GormR/AgOpenGPS_ADS1115_simulator_for_rotary_encoder/AOG_ADS1115_simulator_for_rotary_encoder.png

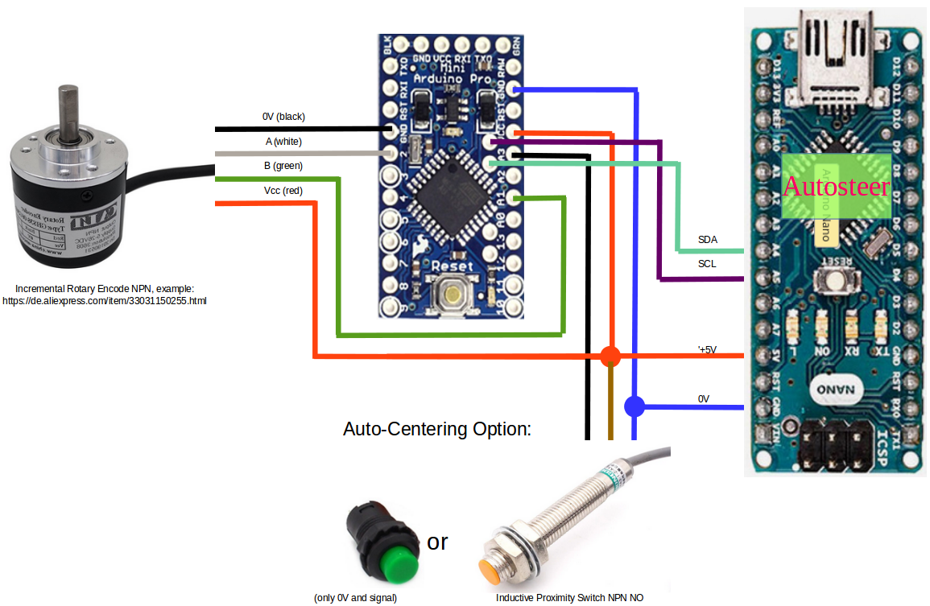
AOG_ADS1115_simulator_for_rotary_encoder.png
