GormR/AgOpenGPS_ADS1115_simulator_for_rotary_encoder/README.md

# AgOpenGPS_ADS1115_simulator_for_rotary_encoder
eliminates the need of a wheel angle sensor for AgOpenGPS when using a steering wheel motor and rotary encoder
