GormR/AgOpenGPS_ADS1115_simulator_for_rotary_encoder/20201010_183013_resized.jpg

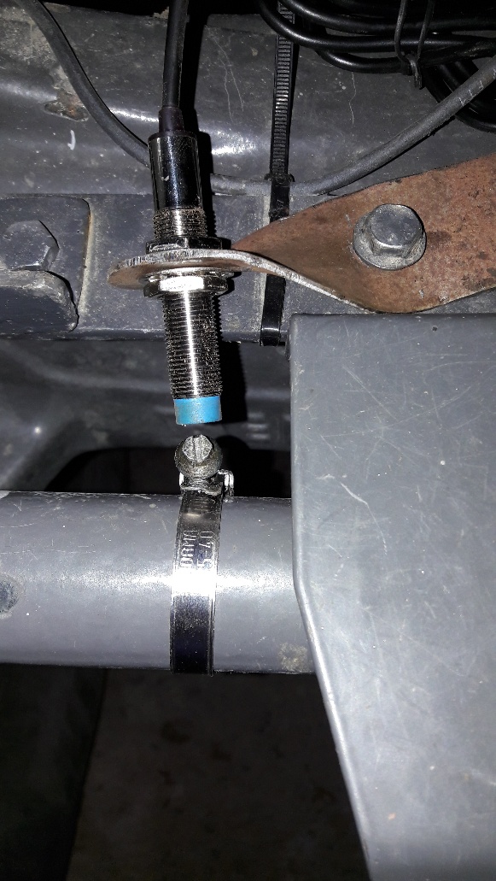
20201010_183013_resized.jpg
