GormR/AgOpenGPS_ADS1115_simulator_for_rotary_encoder/AOG_Autosteer_4.3.10_for_rotary_encoder.png

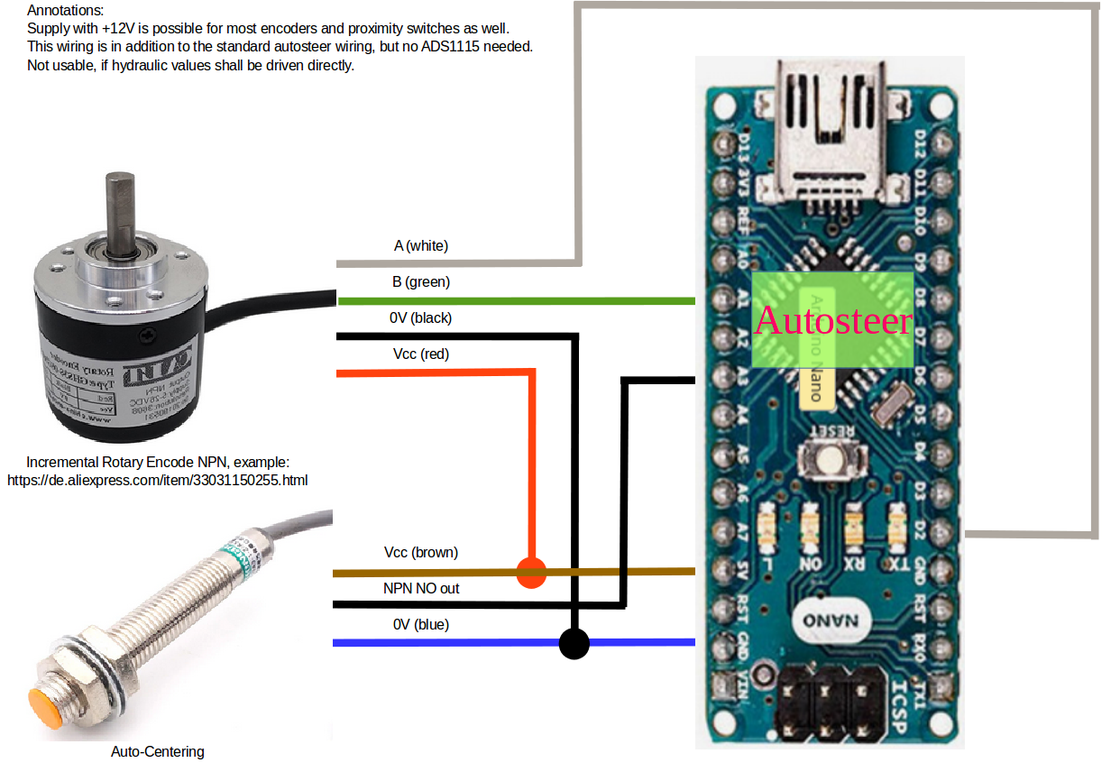
AOG_Autosteer_4.3.10_for_rotary_encoder.png
