GormR/AgOpenGPS_ADS1115_simulator_for_rotary_encoder/Gear_Rotary_Encoder.stl

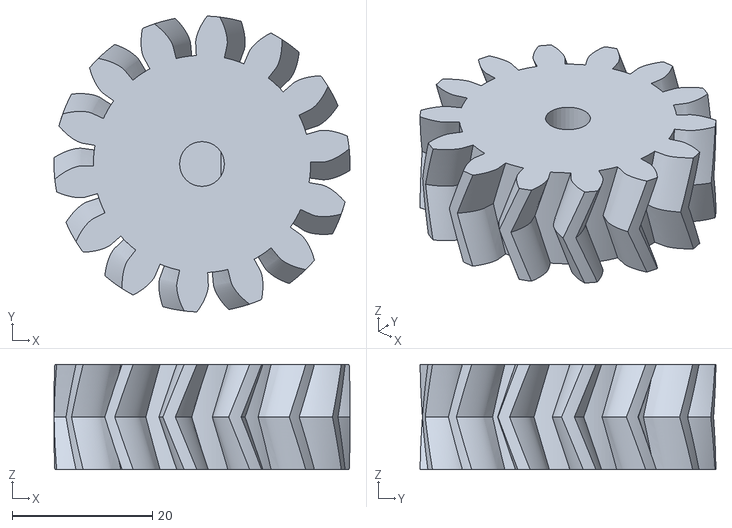
[picture p5: CAD file, 2020-10-09]
Gear_Rotary_Encoder.stl
42.2 x 42.2 x 15.0
