GormR/AgOpenGPS_ADS1115_simulator_for_rotary_encoder/Einrichtung_Drehgeber_für_Lenkung.pdf

Inbetriebnahme
Einrichtung der Lenkwinkelsensorik mit Inkremental-Drehgeber
1. Messung des max. Lenkwinkels als Mittelwert aus dem Winkel des inneren und äußeren Rads
2. Arduino einschalten und einmal kurz nach ganz links und ganz rechts lenken
3. Positive Winkel sollten beim Lenken nach rechts angezeigt werden; sonst „Invert WAS“ aktivieren
4. Werte abspeichern durch Drücken von „Send To Module“ („Ackermann“ := 100%)
5. „Counts per Degree so einstellen, dass der Winkel „Act:“ mit dem in 1. gemessenen übereinstimmt.
5. „Max Steer Angle In Degree“ sollte nun etwas niedriger als der in 1. gemessene Winkel eingestellt werden.
7. Optional, je nach Trecker: Induktiver Näherungsschalter Type „NPN NO“, dessen Ausgang aktiv (=0V) ist,

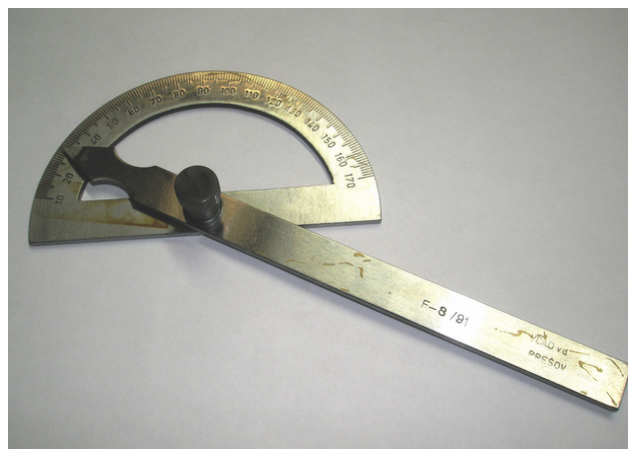
[picture p10: figure]

Wenn der Winkel 0° beträgt | Bild: Wikipedia.com
8. Probiere zu fahren und finde die besten Einstellungen für „Gain“, „Pure P“ and „Stanley“!


(hier abgebildet sind die englischen Originalmenüs, weil die deutsche Übersetzung teilweise missverständlich und unvollständig ist)

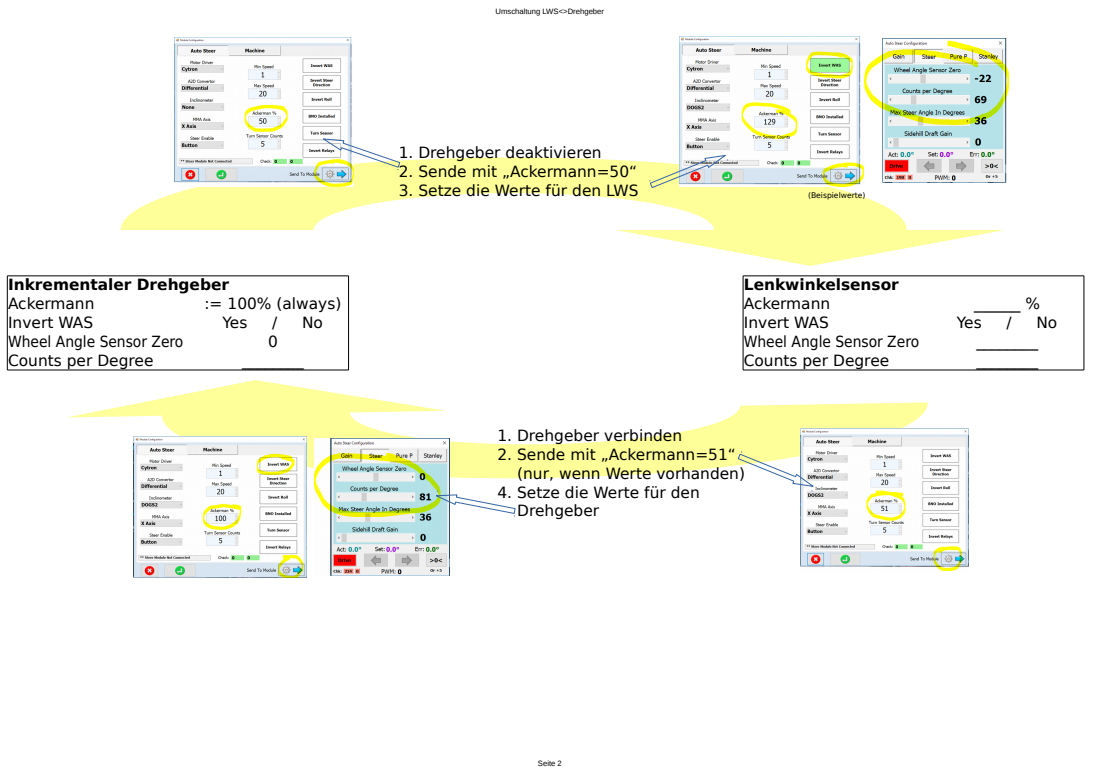
[picture p11: page 2]
3. Setze die Werte für den LWS; (Beispielwerte); Inkrementaler Drehgeber; Lenkwinkelsensor; Ackermann; := 100% (always); Invert WAS; Yes; Wheel Angle Sensor Zero; Counts per Degree

Umschaltung LWS<>Drehgeber

1. Drehgeber deaktivieren
2. Sende mit „Ackermann=50“

1. Drehgeber verbinden
2. Sende mit „Ackermann=51“
(nur, wenn Werte vorhanden)
4. Setze die Werte für den
Drehgeber
