GormR/AgOpenGPS_ADS1115_simulator_for_rotary_encoder/(commit log)

2020-10-05 Add files via upload
    same function, for Autosteer Arduino nano
    - save to EEPROM: when sending Module configuration to Arduino
    - reset EEPROM values: send Module configuration to Arduino with Ackermann=50
    [AOG_Autosteer_USB_4.3.10_for_rotary_encoder.ino]
2020-10-05 Add files via upload
    Schematics..
2020-10-07 Update AOG_Autosteer_USB_4.3.10_for_rotary_encoder.ino
    Bugfix: Save values
    New function: Recall values
    [AOG_Autosteer_USB_4.3.10_for_rotary_encoder.ino]
2020-10-07 How-to incremental rotary encode
    [Encoder_How_to.ods]
2020-10-08 How-to rotary encode as WAS
    eliminates the need of a wheel angle sensor for AgOpenGPS when using a steering wheel motor and rotary encoder
2020-10-08 Anleitung Drehenkoder als Lenkwinkelsensor
    Beschreibt die Einrichtung des Drehenkoders, der den Lenkwinkelsensor ersetzen kann. Benötigt die hier veröffentlichte Autosteer-Software "AOG_Autosteer_USB_4.3.10_for_rotary_encoder.ino".
    Status: in Erprobung
    [Einrichtung_Drehgeber_für_Lenkung.ods]
2020-10-09 Gear for rotary encoder
    Compatible to steering wheel gear:
    https://cerea-forum.de/filebase/index.php?file/80-zahnrad-halterung-valtra/
    Example for rotary encoder:
    https://de.aliexpress.com/item/33031150255.html
    Important: NPN outputs or (even better when suppying it with 5V) push-pull outputs for A and B. Please clarify with Chinease sellers before buying, what you really get... ;)
    600ppr is more than enough..
    [Gear_Rotary_Encoder.stl]
