GormR/AgOpenGPS_ADS1115_simulator_for_rotary_encoder/(notices)

Notices in the files:
AOG_ADS1115_simulator_for_rotary_encoder.ino:
This program is free software: you can redistribute it and/or modify
it under the terms of the GNU General Public License as published by
the Free Software Foundation, version 3.
